designmaster0928/4-Port-Gigabit-Ethernet-Switch/ImpedanceCalculation_JLCPCB.PNG

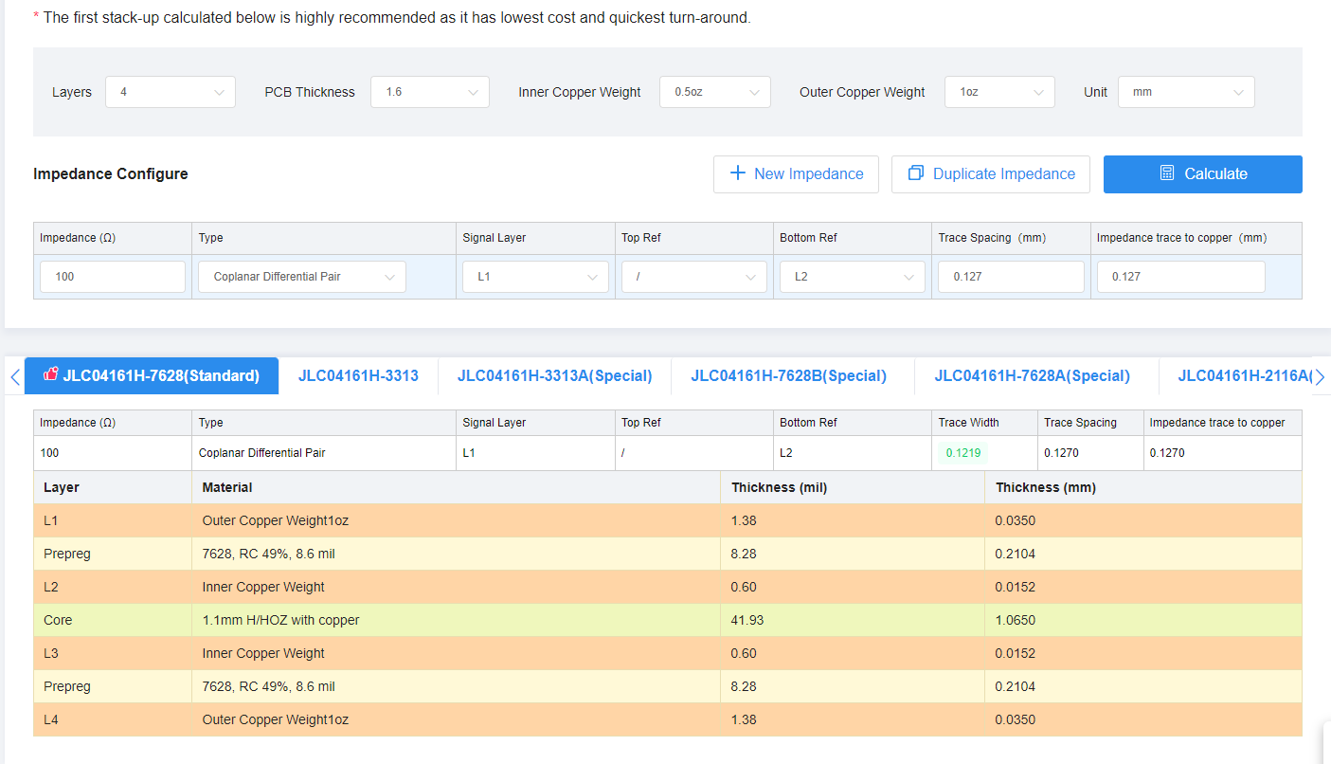
ImpedanceCalculation_JLCPCB.PNG
