designmaster0928/4-Port-Gigabit-Ethernet-Switch/SPI module Pins.PNG

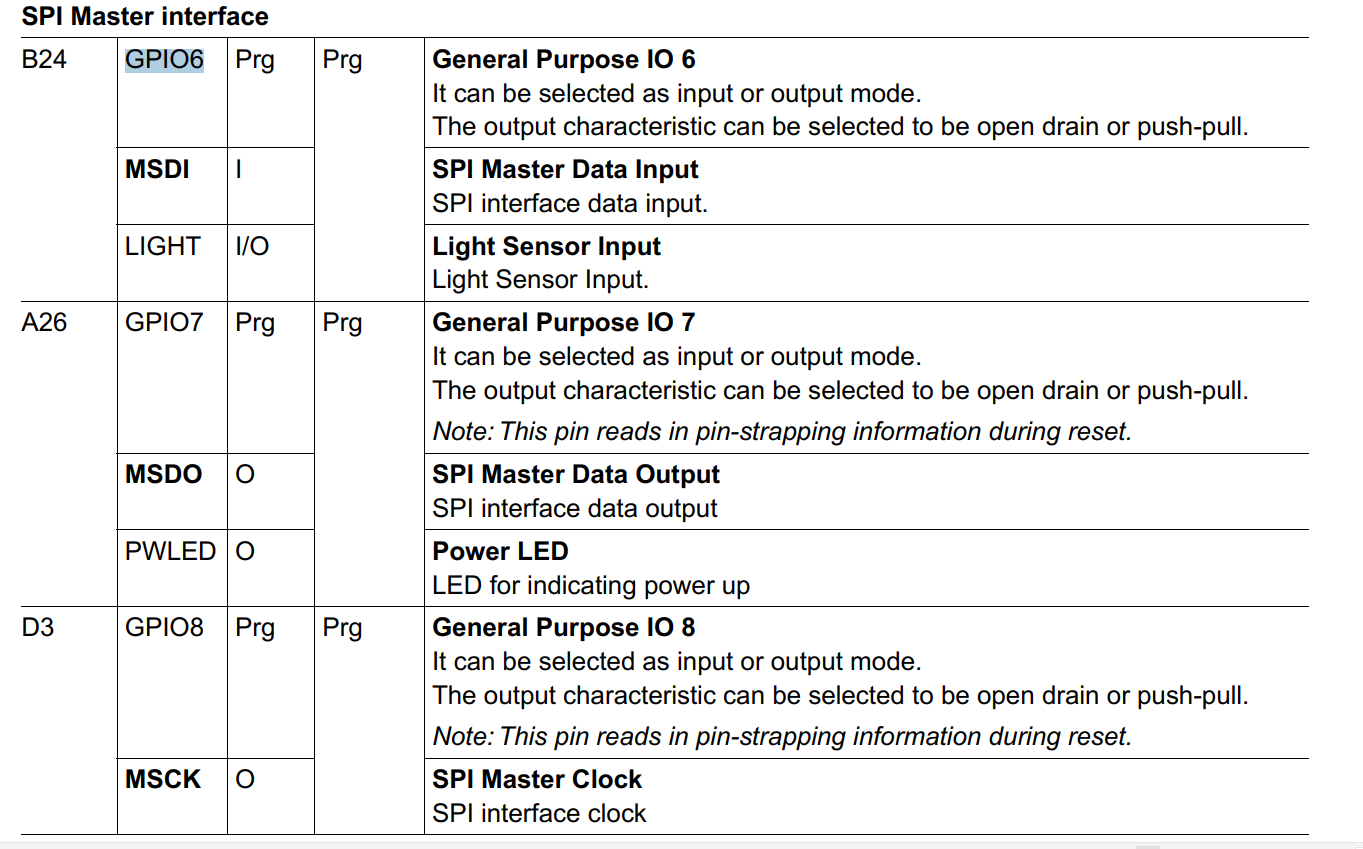
SPI module Pins.PNG
