designmaster0928/4-Port-Gigabit-Ethernet-Switch/Manufacturing Files/Bom_4-Port Gigabit Ethernet Switch.xlsx

Comment | Designator | Footprint | LCSC Part Number | Qty
0.1uF | C1, C2, C3, C4, C9, C11, C16, C19, C20, C21, C22, C23, C24, C25, C26, C27, C28, C29, C30, C31, C32, C33, C34, C35, C36, C37, C38, C39, C40, C41, C42 | Capacitor_SMD:C_0402_1005Metric | C105883 | 31
15pF | C5, C6 | Capacitor_SMD:C_0402_1005Metric | C106997 | 2
10uF/25V | C7, C8, C12, C13, C14, C15, C17, C18 | Capacitor_SMD:C_0805_2012Metric | C89831 | 8
1uF | C10 | Capacitor_SMD:C_0603_1608Metric | C14664 | 1
FerriteBead | FB1 | Inductor_SMD:L_0603_1608Metric | C14709 | 1
RB1-125B8G1A | J1, J2, J3, J4 | Connector_RJ:RJ45_UDE_RB1-125B8G1A | C363353 | 4
TYPE-C-31-M-12 | J5 | TYPE-C-31-M-12:HRO_TYPE-C-31-M-12 | C165948 | 1
15uH | L1 | Inductor_SMD:L_Bourns-SRN4018 | C167809 | 1
0.47uH | L2 | Inductor_SMD:L_Taiyo-Yuden_MD-2020 | C222840 | 1
100R | R1, R2, R3, R4, R5, R6, R7, R8 | Resistor_SMD:R_0402_1005Metric | C106232 | 8
5.1k | R9, R10 | Resistor_SMD:R_0402_1005Metric | C105872 | 2
10k | R11, R13, R14, R15, R17, R18, R19, R20, R21, R22, R23, R24, R25 | Resistor_SMD:R_0402_1005Metric | C60490 | 13
31.6k | R12 | Resistor_SMD:R_0402_1005Metric | C276265 | 1
12.1k | R16 | Resistor_SMD:R_0402_1005Metric | C132157 | 1
SW_Push | SW1 | Button_Switch_SMD:SW_Push_SPST_NO_Alps_SKRK | C455281 | 1
GSW140A3MC_S_LMHB | U1 | GSW140A3MC_S_LMHB:XCVR_GSW140A3MC_S_LMHB | C7501892 | 1
MCP16311T-E/MNY | U2 | Package_DFN_QFN:DFN-8-1EP_3x2mm_P0.5mm_EP1.75x1.45mm | C510882 | 1
TPS62822DLCR | U3 | Package_DFN_QFN:Texas_VSON-HR-8_1.5x2mm_P0.5mm | C473385 | 1
ABM8G-25.000MHZ-B4Y-T | Y1 | ABM8G-25.000MHZ-B4Y-T:XTAL_ABM8G-25.000MHZ-B4Y-T | C9006 | 1
