designmaster0928/4-Port-Gigabit-Ethernet-Switch/4-Port Gigabit Ethernet Switch.pdf

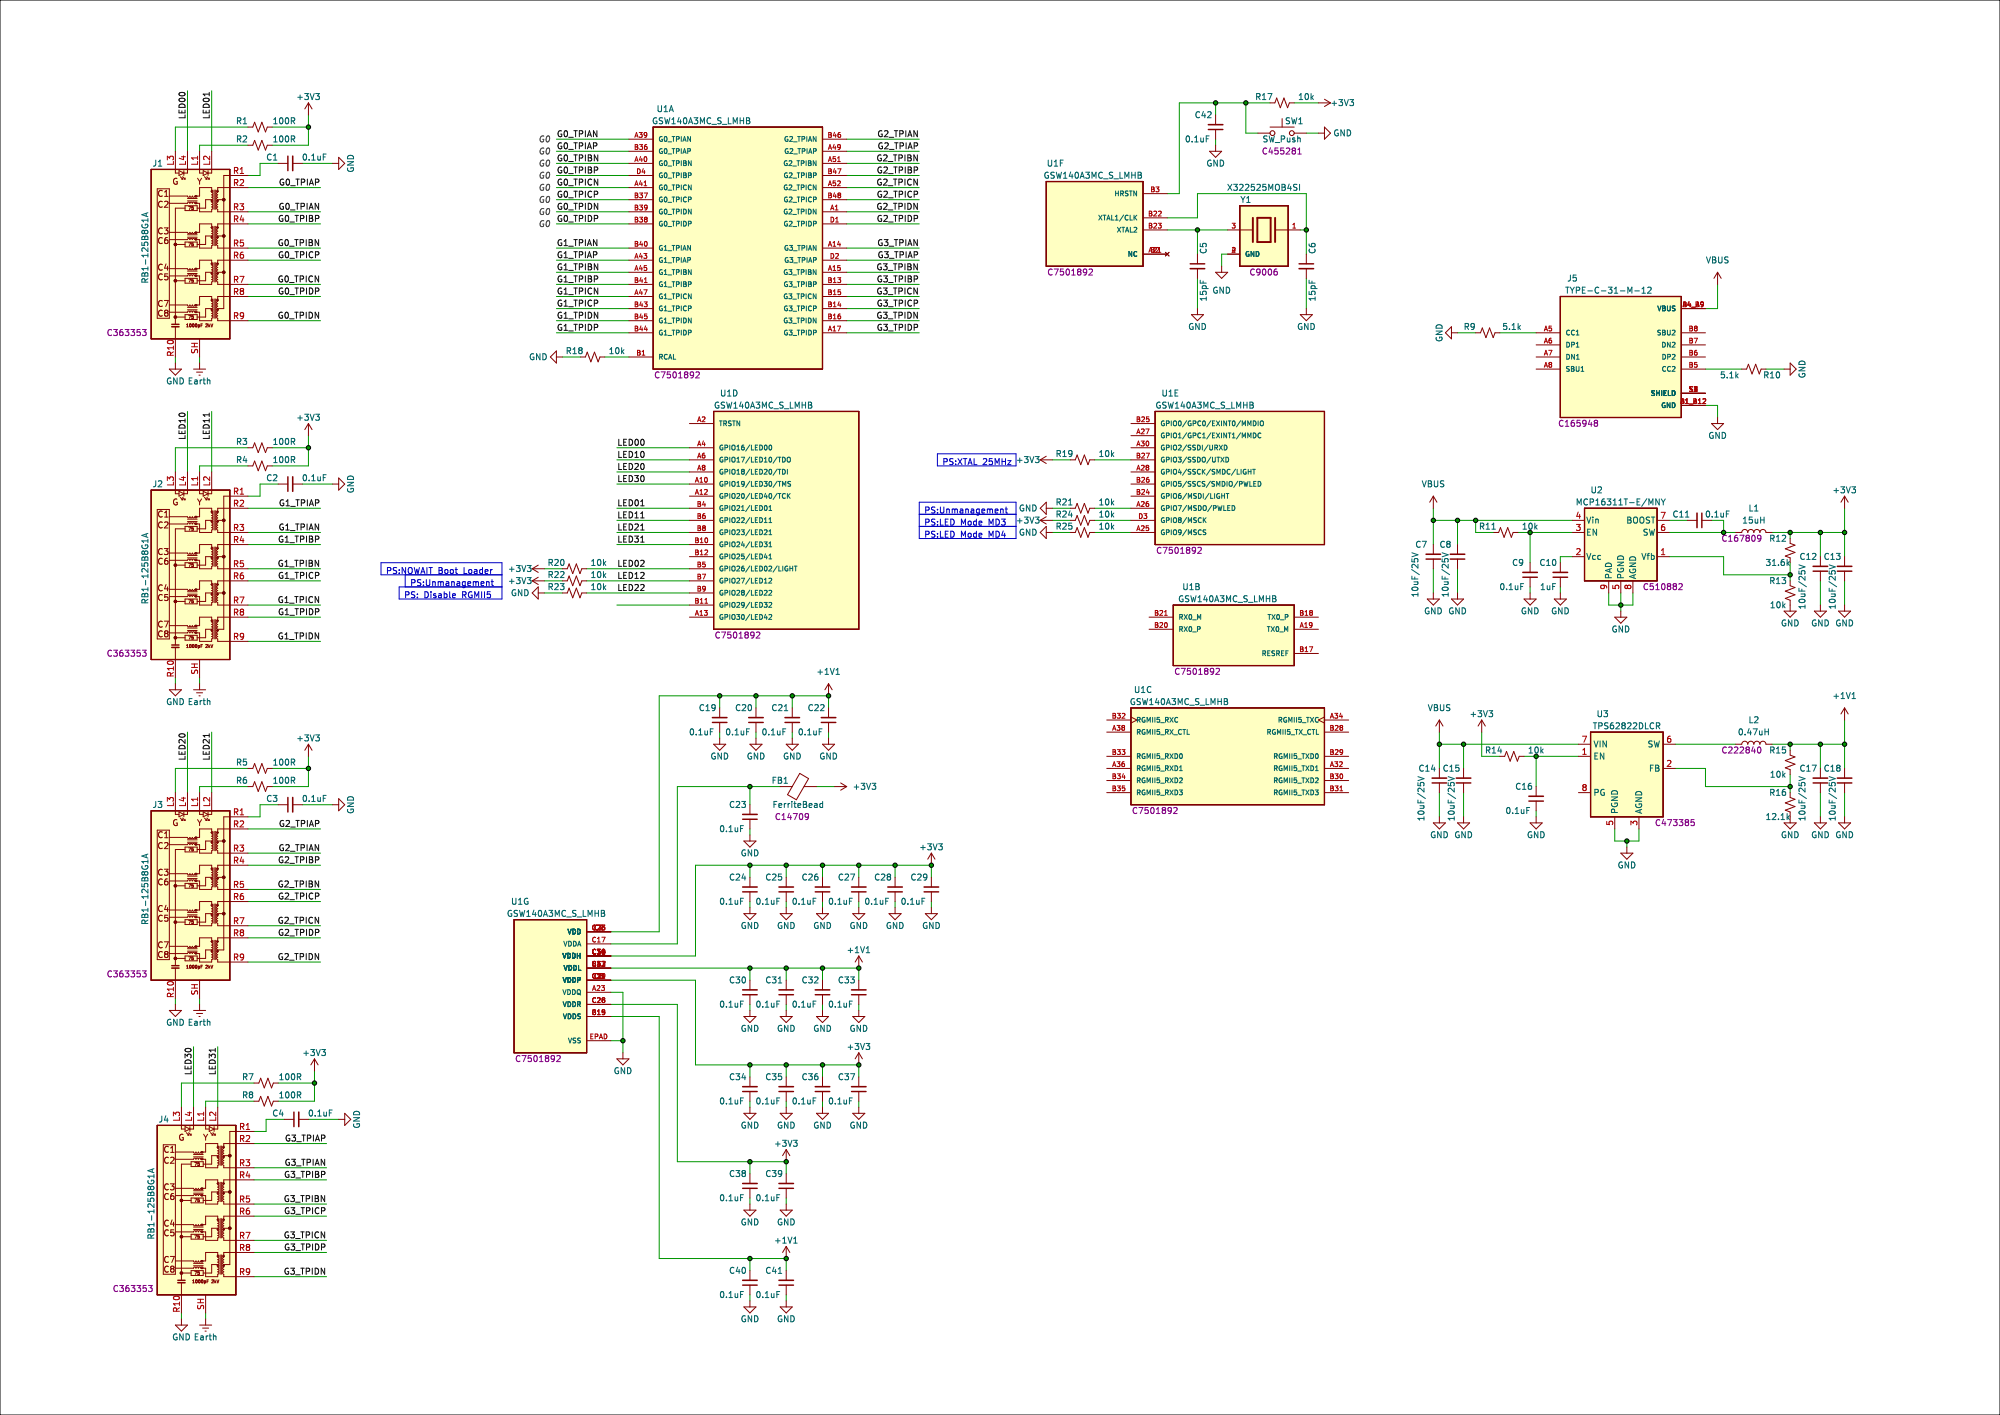
[picture p3: page 1]
