designmaster0928/4-Port-Gigabit-Ethernet-Switch/(list of files, drawings)

Other design files:
datasheets/reference/ksz8795_9031_reference_v1referencedesignschematics/KSZ8765_9031_REFERENCE_V1.DSN
datasheets/reference/ksz8795_9031_reference_v1referencedesignschematics/KSZ8795_9031_REFERENCE_V1.DSN
datasheets/reference/TIDA-00290/TIDC530/TIDA-00290-Motherboard-PWR612A-Files/PWR612A.PcbDoc
datasheets/reference/TIDA-00290/TIDC530/TIDA-00290-Motherboard-PWR612A-Files/PWR612A.PrjPcb
datasheets/reference/TIDA-00290/TIDC530/TIDA-00290-Motherboard-PWR612A-Files/PWR612A_SH1.SchDoc
datasheets/reference/TIDA-00290/TIDC530/TIDA-00290-Motherboard-PWR612A-Files/PWR612A_SH2.SchDoc
