designmaster0928/4-Port-Gigabit-Ethernet-Switch/4-Port Gigabit Ethernet Switch.kicad_pcb

## KiCad design 4-Port Gigabit Ethernet Switch.kicad_pcb (2023-10-01)

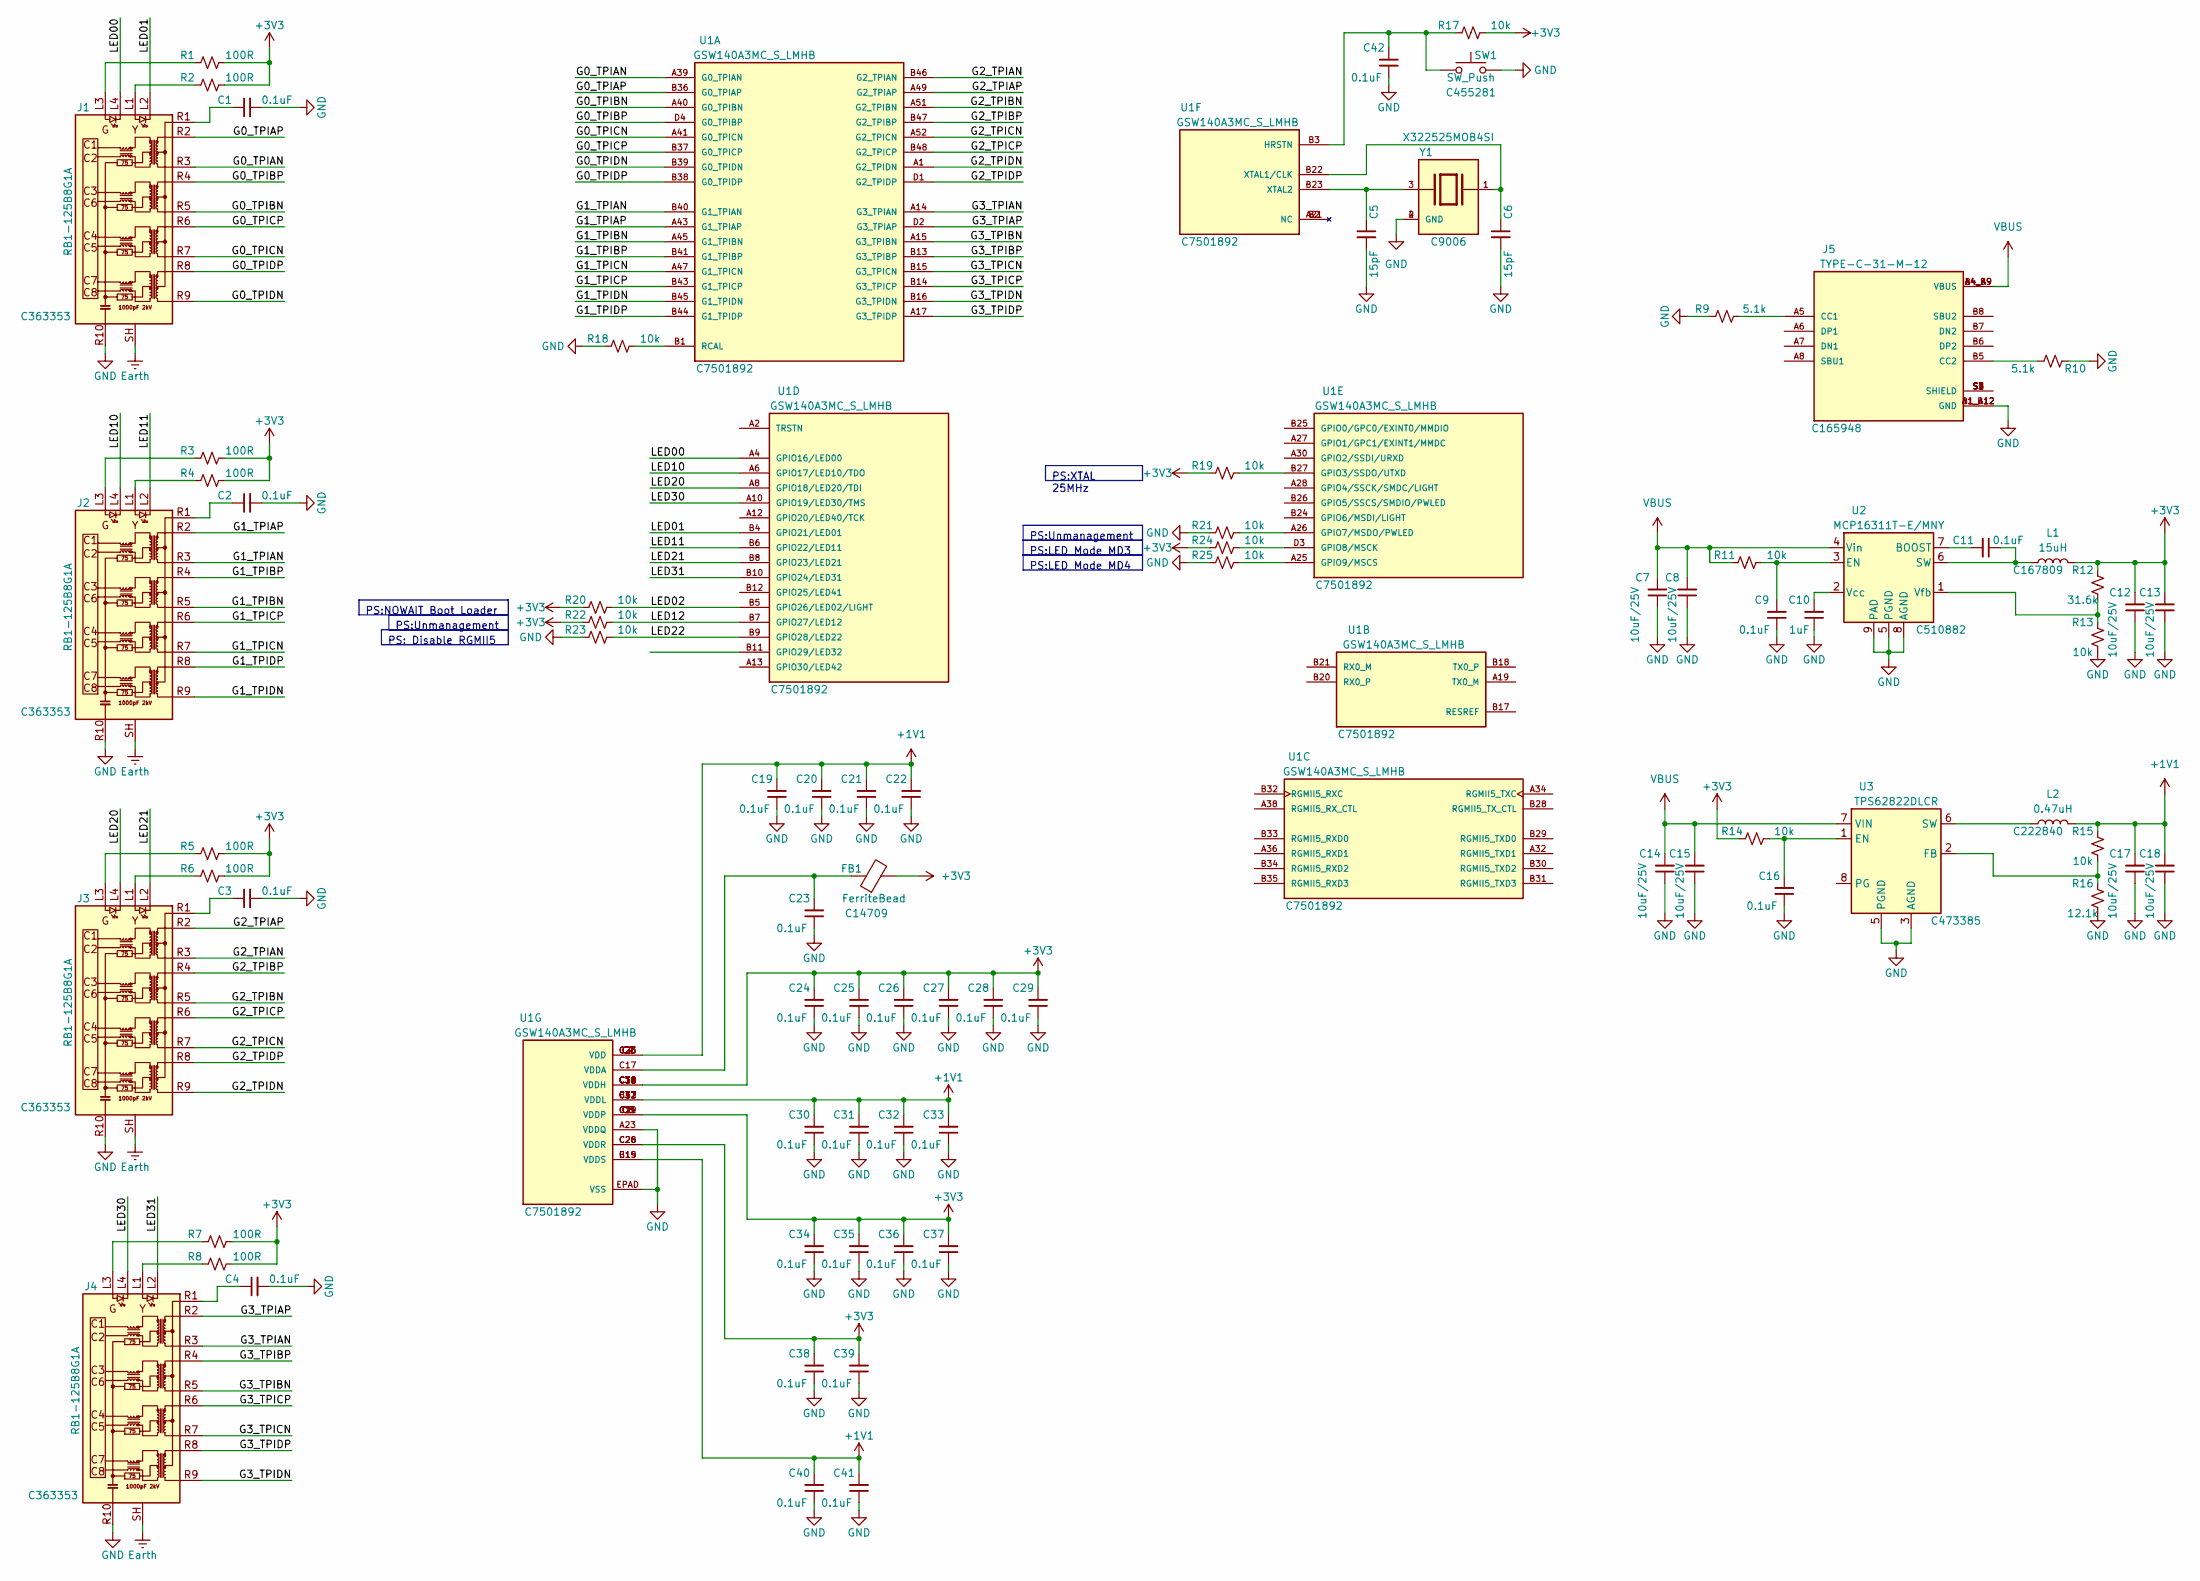
[picture p4: schematic 4-Port Gigabit Ethernet Switch.kicad_sch]

Parts:
C1, C2, C3, C4, C9, C11, C16, C19, C20, C21, C22, C23, C24, C25, C26, C27, C28, C29, C30, C31, C32, C33, C34, C35, C36, C37, C38, C39, C40, C41, C42: 0.1uF; C_0402_1005Metric; LCSC C105883
C5, C6: 15pF; C_0402_1005Metric; LCSC C106997
C7, C8, C12, C13, C14, C15, C17, C18: 10uF/25V; C_0805_2012Metric; LCSC C89831
C10: 1uF; C_0603_1608Metric; LCSC C14664
FB1: FerriteBead; L_0603_1608Metric; LCSC C14709
J1, J2, J3, J4: RB1-125B8G1A; RJ45_UDE_RB1-125B8G1A; LCSC C363353
J5: TYPE-C-31-M-12; HRO_TYPE-C-31-M-12; PARTREV 2020.12.08; LCSC C165948
L1: 15uH; L_Bourns-SRN4018; LCSC C167809
L2: 0.47uH; L_Taiyo-Yuden_NR-24xx; LCSC C222840
R1, R2, R3, R4, R5, R6, R7, R8: 100R; R_0402_1005Metric; LCSC C106232
R9, R10: 5.1k; R_0402_1005Metric; LCSC C105872
R11, R13, R14, R15, R17, R18, R19, R20, R21, R22, R23, R24, R25: 10k; R_0402_1005Metric; LCSC C60490
R12: 31.6k; R_0402_1005Metric; LCSC C276265
R16: 12.1k; R_0402_1005Metric; LCSC C132157
SW1: SW_Push; SW_Push_SPST_NO_Alps_SKRK; LCSC C455281
U1: GSW140A3MC_S_LMHB; XCVR_GSW140A3MC_S_LMHB; PARTREV 1.11mm; LCSC C7501892
U2: MCP16311T-E/MNY; DFN-8-1EP_3x2mm_P0.5mm_EP1.75x1.45mm; LCSC C510882
U3: TPS62822DLCR; Texas_VSON-HR-8_1.5x2mm_P0.5mm; LCSC C473385
Y1: X322525MOB4SI; XTAL_ABM8G-25.000MHZ-B4Y-T; LCSC C9006

Connections:
+1V1: C17.2, C18.2, C19.2, C20.2, C21.2, C22.2, C30.2, C31.2, C32.2, C33.2, C40.2, C41.2, L2.2, R15.2, U1.B19 (VDDS), U1.B42 (VDDL), U1.C2 (VDD), U1.C4 (VDD), U1.C12 (VDDL), U1.C15 (VDDS), U1.C23 (VDD), U1.C25 (VDD), U1.C33 (VDDL), U1.C37 (VDDL)
+3V3: C12.2, C13.2, C24.2, C25.2, C26.2, C27.2, C28.2, C29.2, C34.2, C35.2, C36.2, C37.2, C38.2, C39.2, FB1.2, L1.2, R1.2, R2.2, R3.2, R4.2, R5.2, R6.2, R7.2, R8.2, R12.2, R14.1, R17.2, R19.1, R20.1, R22.1, R24.1, U1.C6 (VDDP), U1.C8 (VDDP), U1.C10 (VDDH), U1.C14 (VDDH), U1.C19 (VDDP), U1.C21 (VDDP), U1.C26 (VDDR), U1.C28 (VDDR), U1.C31 (VDDH), U1.C34 (VDDH), U1.C36 (VDDH), U1.C39 (VDDH)
/G0_TPIAN: J1.R3 (TD1-), U1.A39 (G0_TPIAN)
/G0_TPIAP: J1.R2 (TD1+), U1.B36 (G0_TPIAP)
/G0_TPIBN: J1.R5 (TD2-), U1.A40 (G0_TPIBN)
/G0_TPIBP: J1.R4 (TD2+), U1.D4 (G0_TPIBP)
/G0_TPICN: J1.R7 (TD3-), U1.A41 (G0_TPICN)
/G0_TPICP: J1.R6 (TD3+), U1.B37 (G0_TPICP)
/G0_TPIDN: J1.R9 (TD4-), U1.B39 (G0_TPIDN)
/G0_TPIDP: J1.R8 (TD4+), U1.B38 (G0_TPIDP)
/G1_TPIAN: J2.R3 (TD1-), U1.B40 (G1_TPIAN)
/G1_TPIAP: J2.R2 (TD1+), U1.A43 (G1_TPIAP)
/G1_TPIBN: J2.R5 (TD2-), U1.A45 (G1_TPIBN)
/G1_TPIBP: J2.R4 (TD2+), U1.B41 (G1_TPIBP)
/G1_TPICN: J2.R7 (TD3-), U1.A47 (G1_TPICN)
/G1_TPICP: J2.R6 (TD3+), U1.B43 (G1_TPICP)
/G1_TPIDN: J2.R9 (TD4-), U1.B45 (G1_TPIDN)
/G1_TPIDP: J2.R8 (TD4+), U1.B44 (G1_TPIDP)
/G2_TPIAN: J3.R3 (TD1-), U1.B46 (G2_TPIAN)
/G2_TPIAP: J3.R2 (TD1+), U1.A49 (G2_TPIAP)
/G2_TPIBN: J3.R5 (TD2-), U1.A51 (G2_TPIBN)
/G2_TPIBP: J3.R4 (TD2+), U1.B47 (G2_TPIBP)
/G2_TPICN: J3.R7 (TD3-), U1.A52 (G2_TPICN)
/G2_TPICP: J3.R6 (TD3+), U1.B48 (G2_TPICP)
/G2_TPIDN: J3.R9 (TD4-), U1.A1 (G2_TPIDN)
/G2_TPIDP: J3.R8 (TD4+), U1.D1 (G2_TPIDP)
/G3_TPIAN: J4.R3 (TD1-), U1.A14 (G3_TPIAN)
/G3_TPIAP: J4.R2 (TD1+), U1.D2 (G3_TPIAP)
/G3_TPIBN: J4.R5 (TD2-), U1.A15 (G3_TPIBN)
/G3_TPIBP: J4.R4 (TD2+), U1.B13 (G3_TPIBP)
/G3_TPICN: J4.R7 (TD3-), U1.B15 (G3_TPICN)
/G3_TPICP: J4.R6 (TD3+), U1.B14 (G3_TPICP)
/G3_TPIDN: J4.R9 (TD4-), U1.B16 (G3_TPIDN)
/G3_TPIDP: J4.R8 (TD4+), U1.A17 (G3_TPIDP)
/LED00: J1.L4, U1.A4 (GPIO16/LED00)
/LED01: J1.L2, U1.B4 (GPIO21/LED01)
/LED02: R20.2, U1.B5 (GPIO26/LED02/LIGHT)
/LED10: J2.L4, U1.A6 (GPIO17/LED10/TDO)
/LED11: J2.L2, U1.B6 (GPIO22/LED11)
/LED12: R22.2, U1.B7 (GPIO27/LED12)
/LED20: J3.L4, U1.A8 (GPIO18/LED20/TDI)
/LED21: J3.L2, U1.B8 (GPIO23/LED21)
/LED22: R23.2, U1.B9 (GPIO28/LED22)
/LED30: J4.L4, U1.A10 (GPIO19/LED30/TMS)
/LED31: J4.L2, U1.B10 (GPIO24/LED31)
Earth: J1.SH, J2.SH, J3.SH, J4.SH
GND: C1.2, C2.2, C3.2, C4.2, C5.2, C6.2, C7.1, C8.1, C9.1, C10.1, C12.1, C13.1, C14.1, C15.1, C16.1, C17.1, C18.1, C19.1, C20.1, C21.1, C22.1, C23.1, C24.1, C25.1, C26.1, C27.1, C28.1, C29.1, C30.1, C31.1, C32.1, C33.1, C34.1, C35.1, C36.1, C37.1, C38.1, C39.1, C40.1, C41.1, C42.1, J1.R10 (GND), J2.R10 (GND), J3.R10 (GND), J4.R10 (GND), J5.A1_B12 (GND), J5.B1_A12 (GND), R9.1, R10.1, R13.1, R16.1, R18.1, R21.1, R23.1, R25.1, SW1.2, U1.A23 (VDDQ), U1.EPAD (VSS), U2.5 (PGND), U2.8 (AGND), U2.9 (PAD), U3.3 (AGND), U3.5 (PGND), Y1.2 (GND), Y1.4 (GND)
unnamed: C1.1, J1.R1 (CT)
unnamed: J1.L1, R2.1
unnamed: J1.L3, R1.1
unnamed: C2.1, J2.R1 (CT)
unnamed: J2.L1, R4.1
unnamed: J2.L3, R3.1
unnamed: C3.1, J3.R1 (CT)
unnamed: J3.L1, R6.1
unnamed: J3.L3, R5.1
unnamed: C4.1, J4.R1 (CT)
unnamed: J4.L1, R8.1
unnamed: J4.L3, R7.1
unnamed: J5.A5 (CC1), R9.2
unnamed: J5.B5 (CC2), R10.2
unnamed: J5.S1 (SHIELD), J5.S2 (SHIELD), J5.S3 (SHIELD), J5.S4 (SHIELD)
unnamed: R18.2, U1.B1 (RCAL)
unnamed: R19.2, U1.B27 (GPIO3/SSDO/UTXD)
unnamed: R21.2, U1.A26 (GPIO7/MSDO/PWLED)
unnamed: R24.2, U1.D3 (GPIO8/MSCK)
unnamed: R25.2, U1.A25 (GPIO9/MSCS)
unnamed: C42.2, R17.1, SW1.1, U1.B3 (HRSTN)
unnamed: C6.1, U1.B22 (XTAL1/CLK), Y1.1
unnamed: C5.1, U1.B23 (XTAL2), Y1.3
unnamed: C23.2, FB1.1, U1.C17 (VDDA)
unnamed: C11.2, U2.7 (BOOST)
unnamed: C9.2, R11.2, U2.3 (EN)
unnamed: C11.1, L1.1, U2.6 (SW)
unnamed: C10.2, U2.2 (Vcc)
unnamed: R12.1, R13.2, U2.1 (Vfb)
unnamed: C16.2, R14.2, U3.1 (EN)
unnamed: R15.1, R16.2, U3.2 (FB)
unnamed: L2.1, U3.6 (SW)
VBUS: C7.2, C8.2, C14.2, C15.2, J5.A4_B9 (VBUS), J5.B4_A9 (VBUS), R11.1, U2.4 (Vin), U3.7 (VIN)

Notes on the sheet:
PS:Unmanagement
PS:NOWAIT Boot Loader
PS: Disable RGMII5
PS:LED Mode MD3
PS:XTAL 25MHz
PS:LED Mode MD4

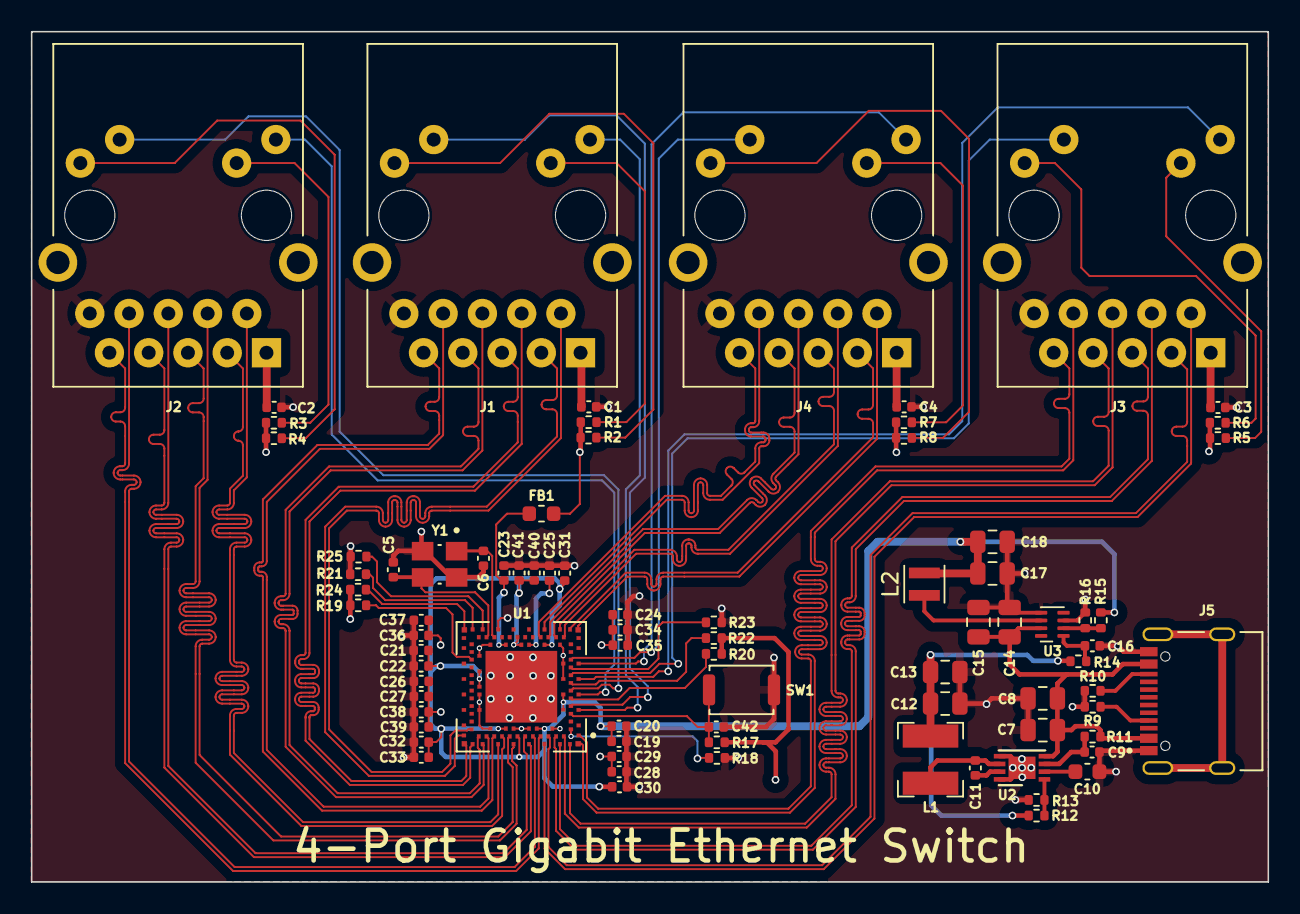
[picture p5: board 4-Port Gigabit Ethernet Switch.kicad_pcb from above]

Board: 4 copper layers, 80.0 x 55.0 mm, 80 parts (0 on the bottom side), 80 nets.
