designmaster0928/4-Port-Gigabit-Ethernet-Switch/JTAG Test Reset.PNG

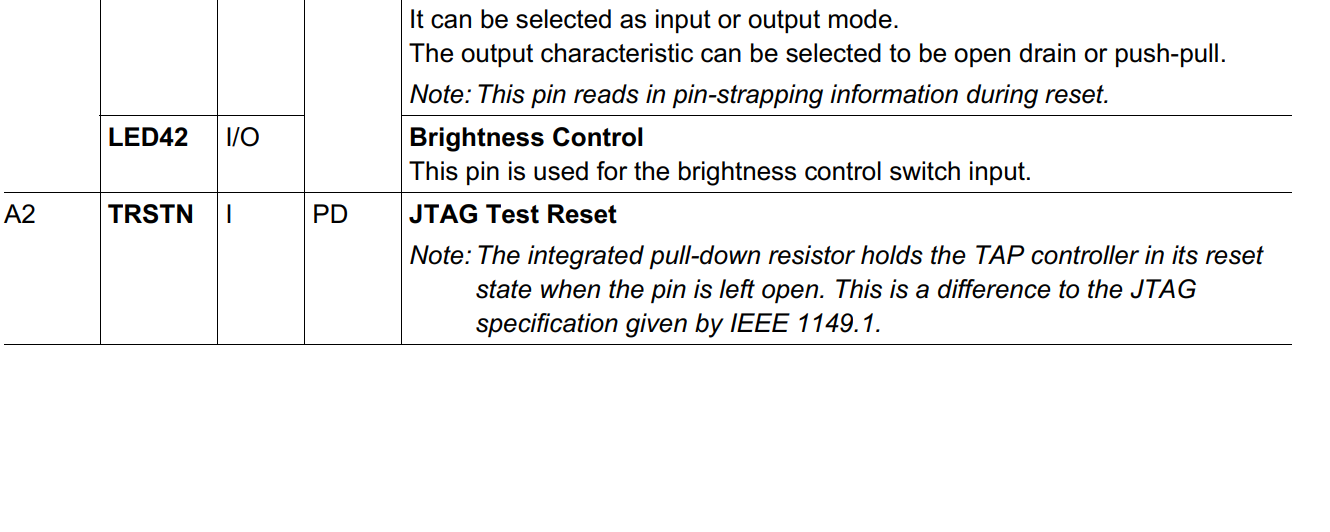
JTAG Test Reset.PNG
